alemarram/TFG_EPS_US_26-27/TFG_Estacion_Meteorologica/Node-RED/Dashboard/Flujo_Estacion_meteorologica.png

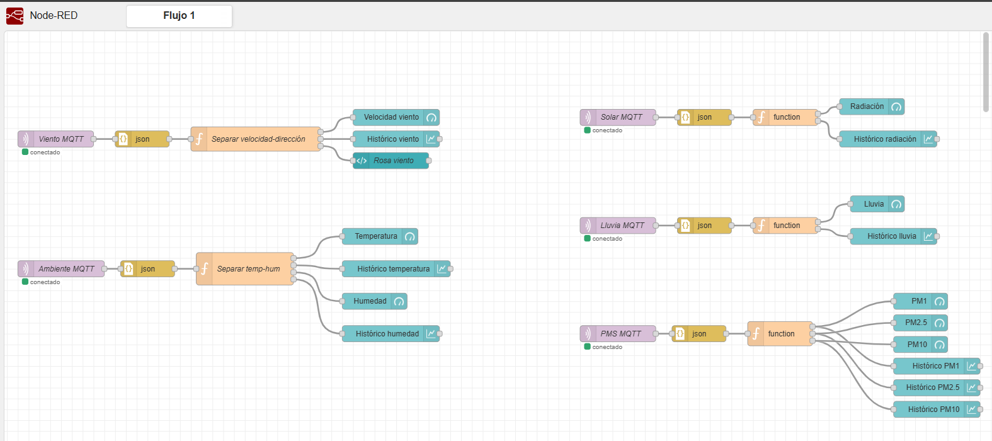
TFG_Estacion_Meteorologica/Node-RED/Dashboard/Flujo_Estacion_meteorologica.png
