alemarram/TFG_EPS_US_26-27/TFG_Estacion_Meteorologica/Node-RED/Dashboard/Radiacion.png

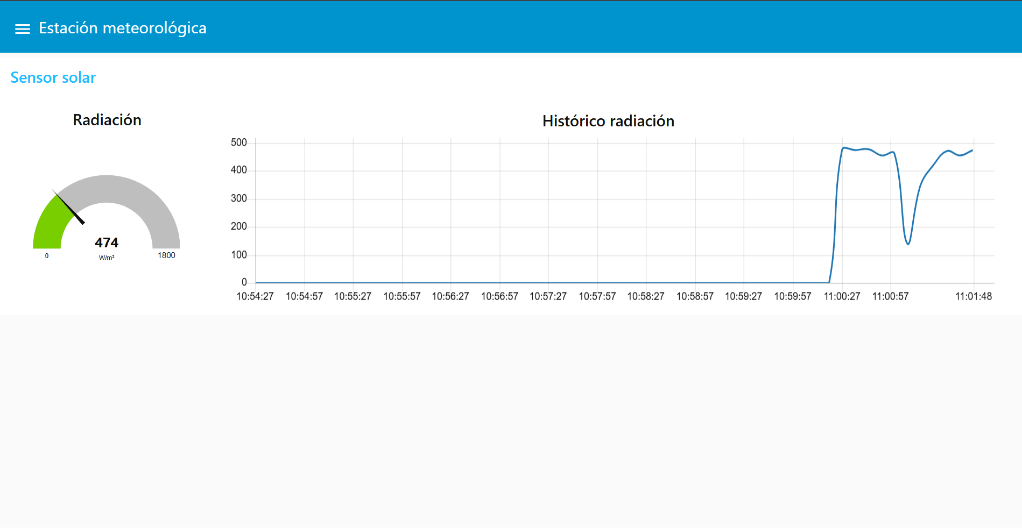
TFG_Estacion_Meteorologica/Node-RED/Dashboard/Radiacion.png
