alemarram/TFG_EPS_US_26-27/TFG_Estacion_Meteorologica/Esquematico/PCB/Plano 2_Componentes_PCB.pdf

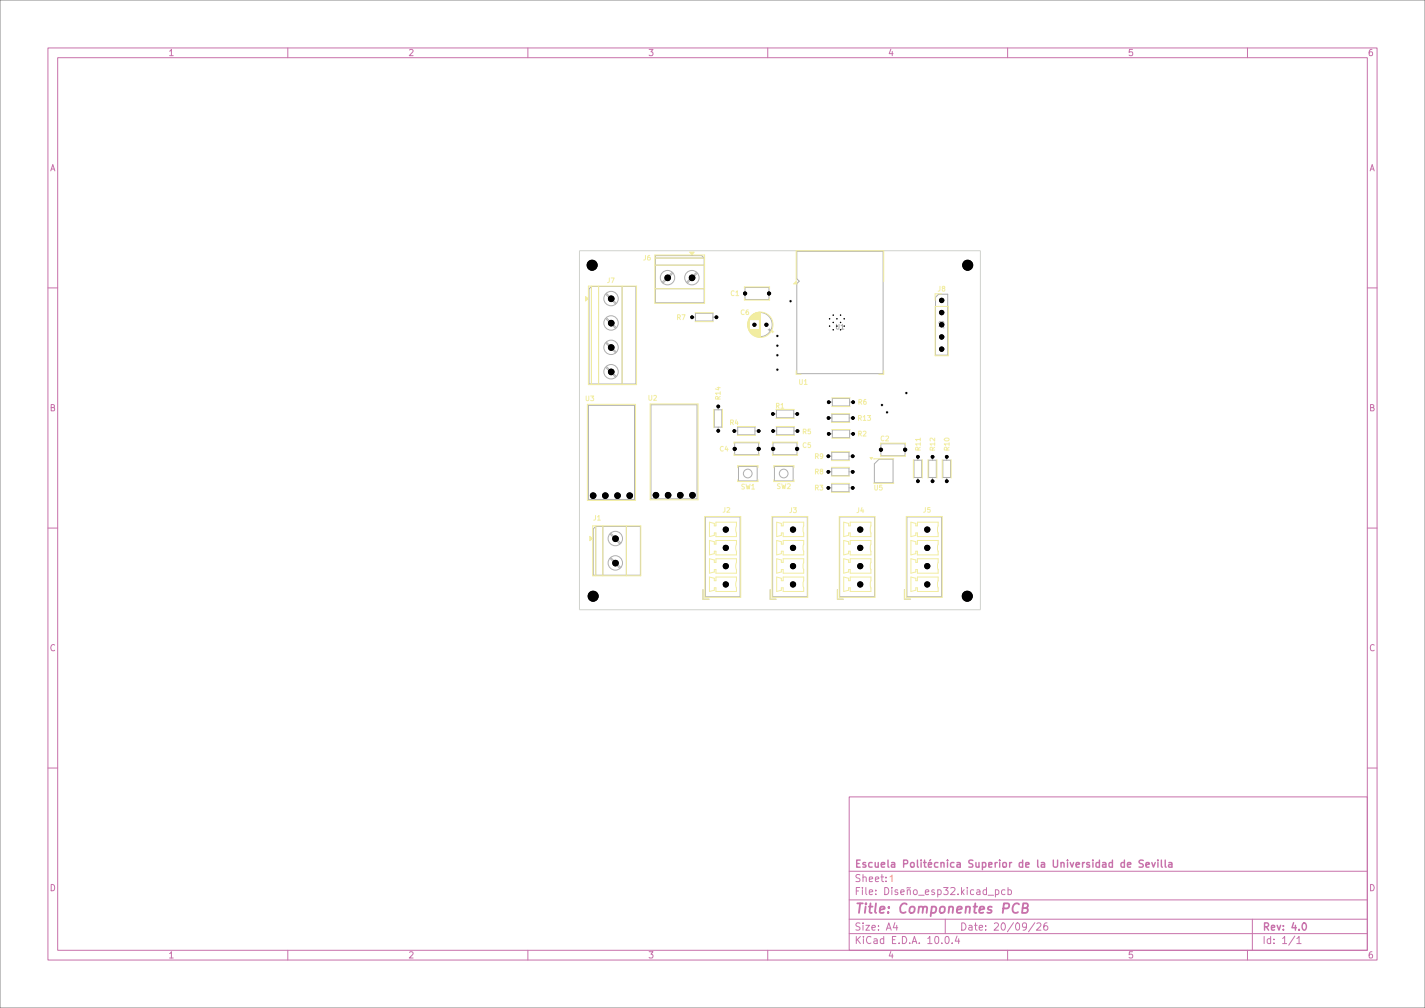
[picture p7: page 1]
