alemarram/TFG_EPS_US_26-27/TFG_Estacion_Meteorologica/Esquematico/PCB/Componentes.pdf

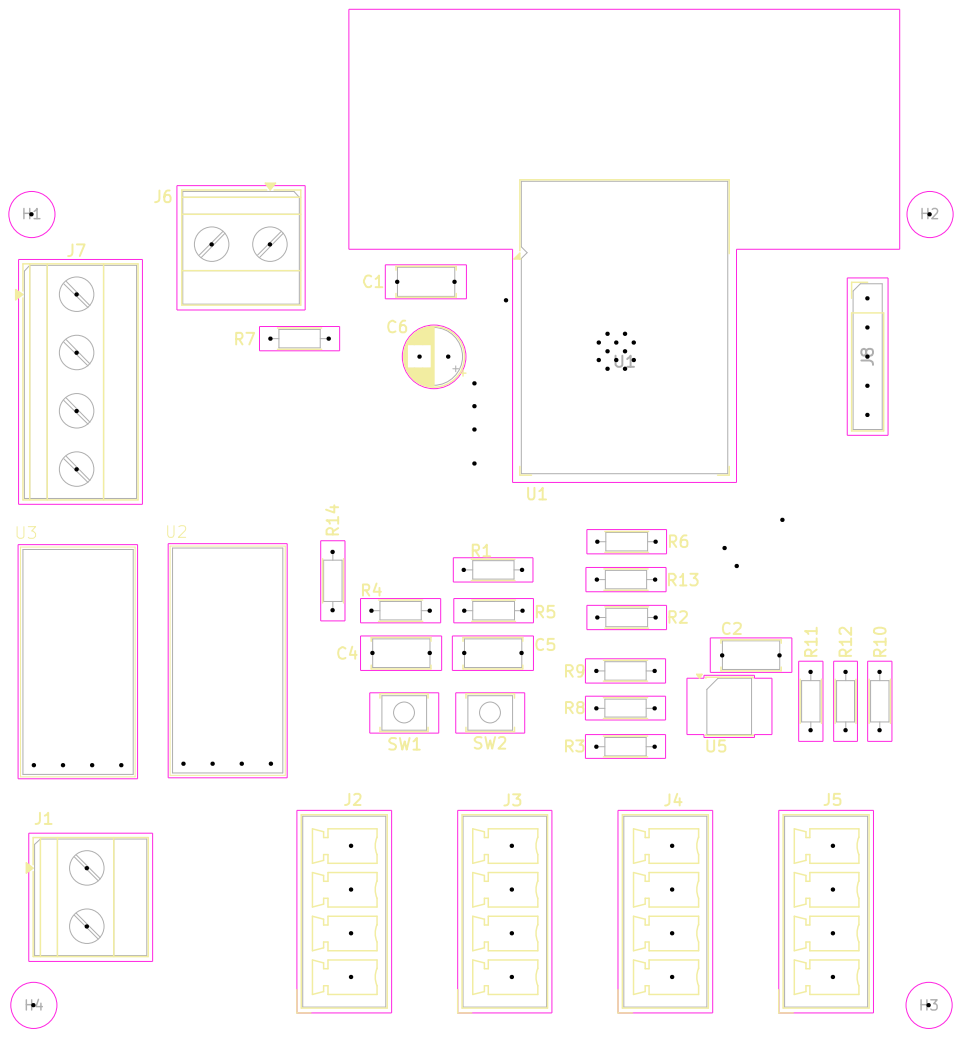
[picture p8: page 1]
