alemarram/TFG_EPS_US_26-27/TFG_Estacion_Meteorologica/Esquematico/Plano 1_Esquemático_PCB.pdf

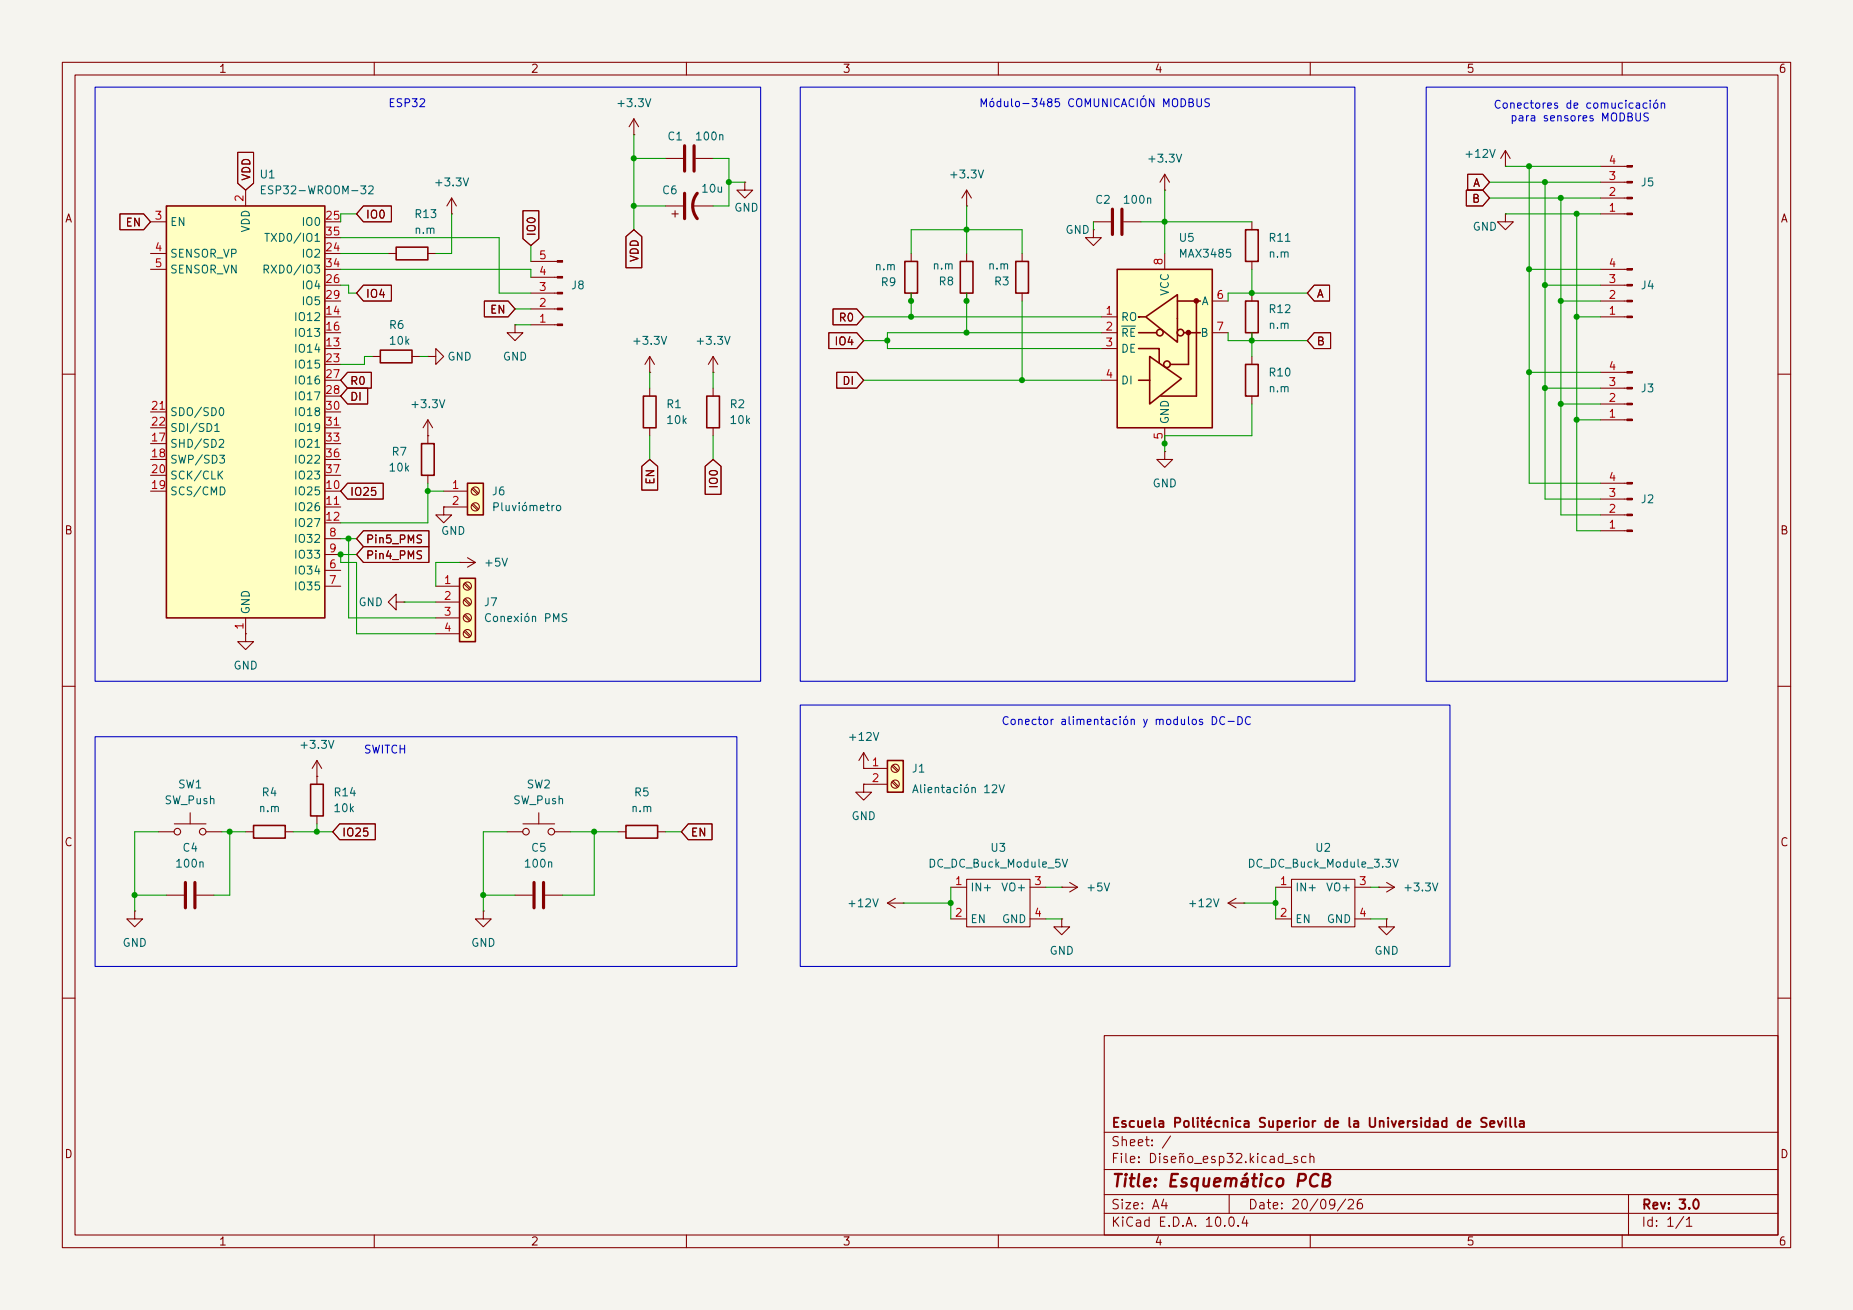
[picture p9: page 1]
