alemarram/TFG_EPS_US_26-27/TFG_Estacion_Meteorologica/Esquematico/Plano 6_Estación_completa.pdf

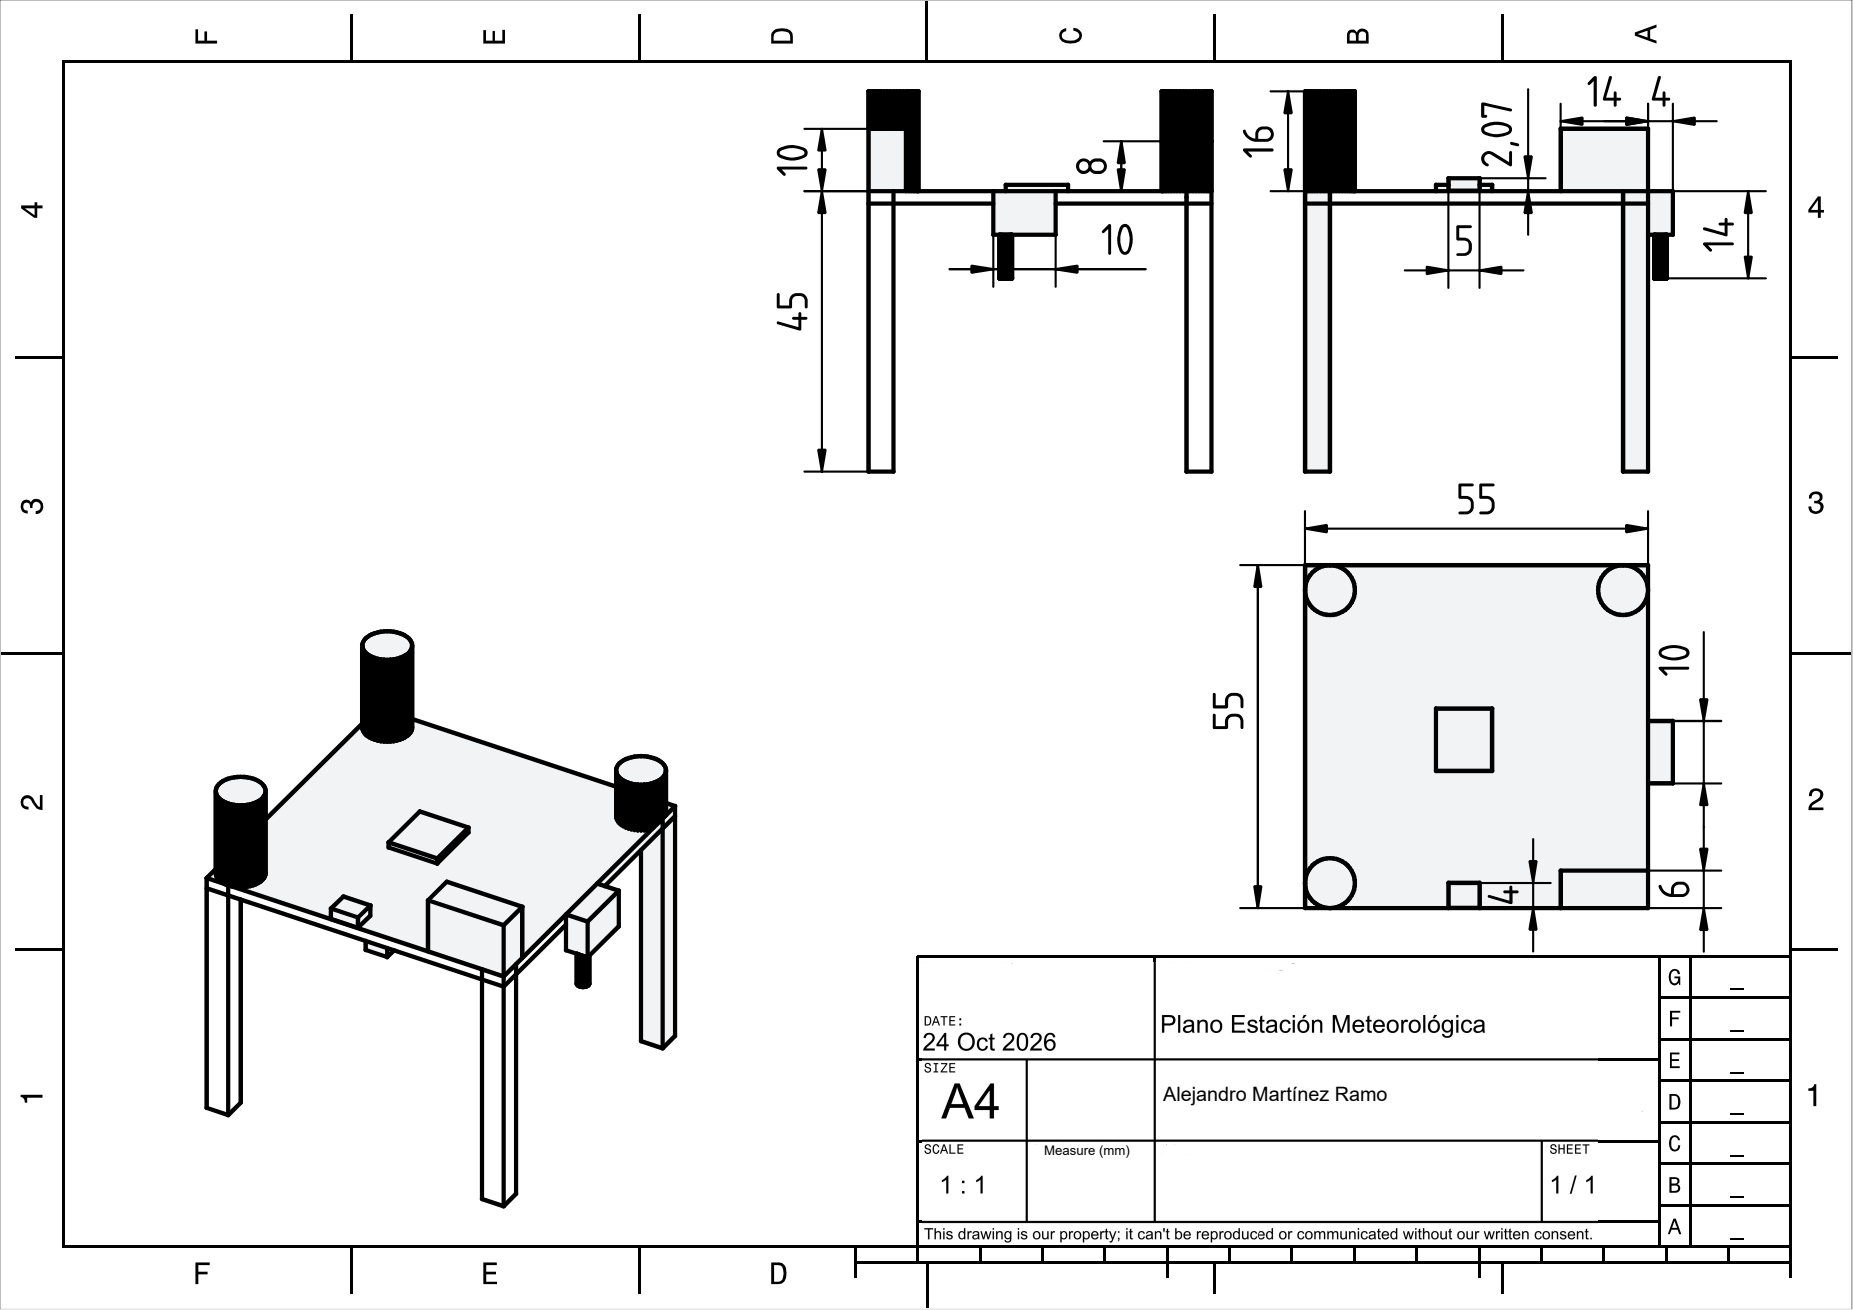
[picture p10: page 1]

DESIGNED BY: DATE: 24 Oct 2026 | Sin no mbre Plano Es tación Meteorológica

SIZE A4 | Alejandro Martínez Ramo

SCALE WEIGHT (kg) Measure (mm) 1:1 | DRAWING NUMB ER SHEET 1/1

This drawing is our property; it can't be reproduce

or communicated without our written consent.
