alemarram/TFG_EPS_US_26-27/TFG_Estacion_Meteorologica/Esquematico/Plano 5_Estación_completa.pdf

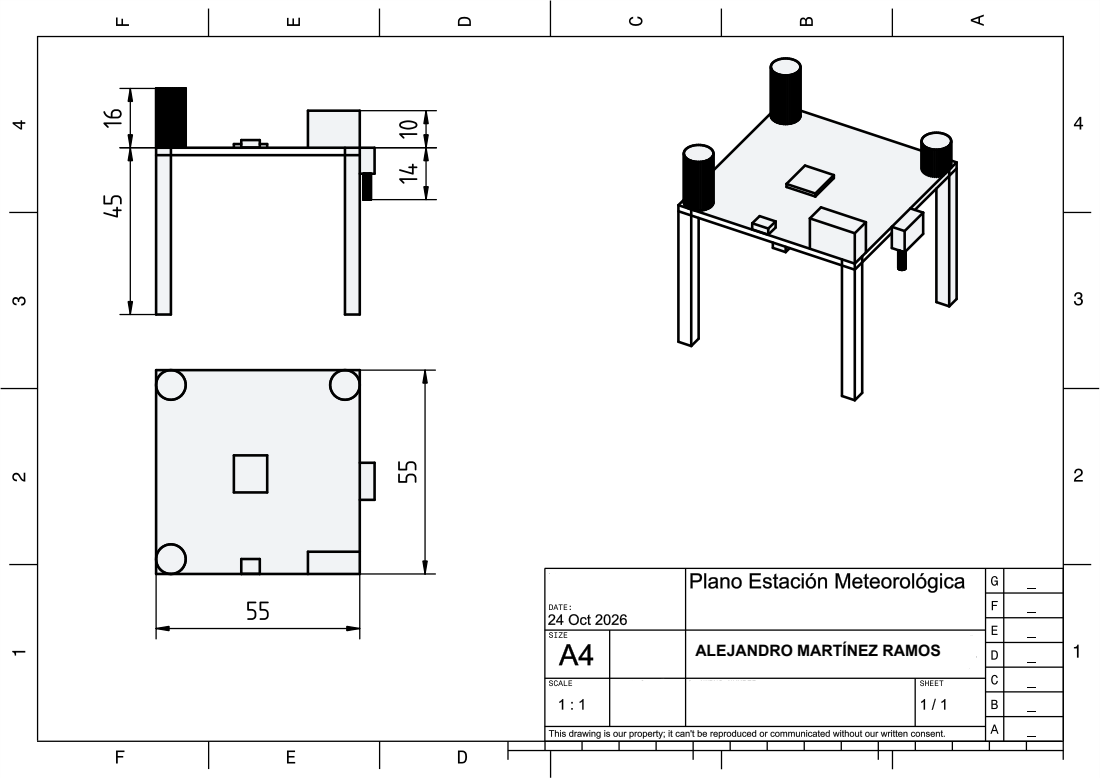
[picture p11: page 1]

ALEJANDRO MARTÍNEZ RAMOS
