alemarram/TFG_EPS_US_26-27/TFG_Estacion_Meteorologica/Esquematico/Esquematico.pdf

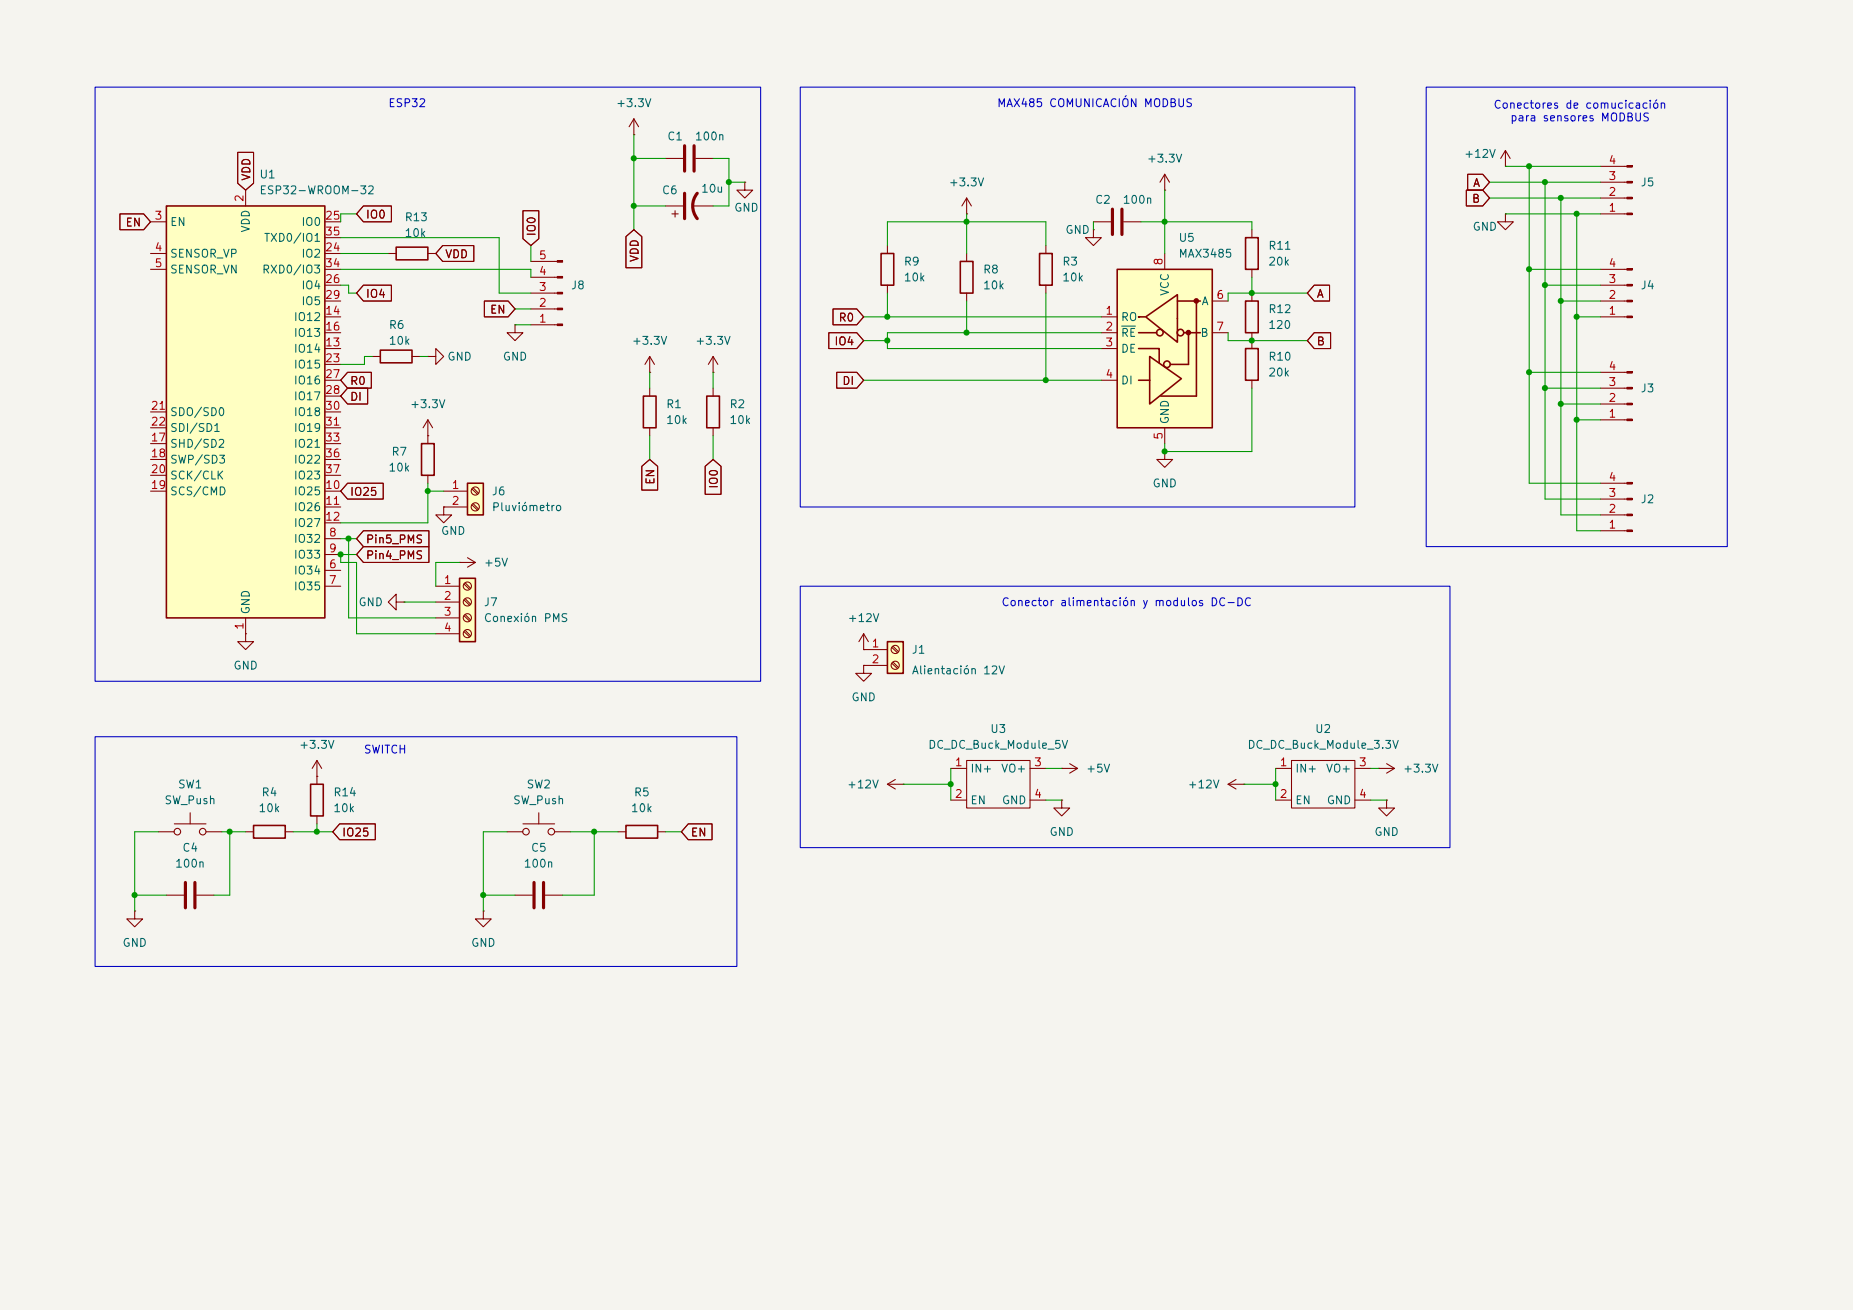
[picture p12: page 1]
