alemarram/TFG_EPS_US_26-27/TFG_Estacion_Meteorologica/Esquematico/PCB/Plano 4_Cara_superior_PCB.pdf

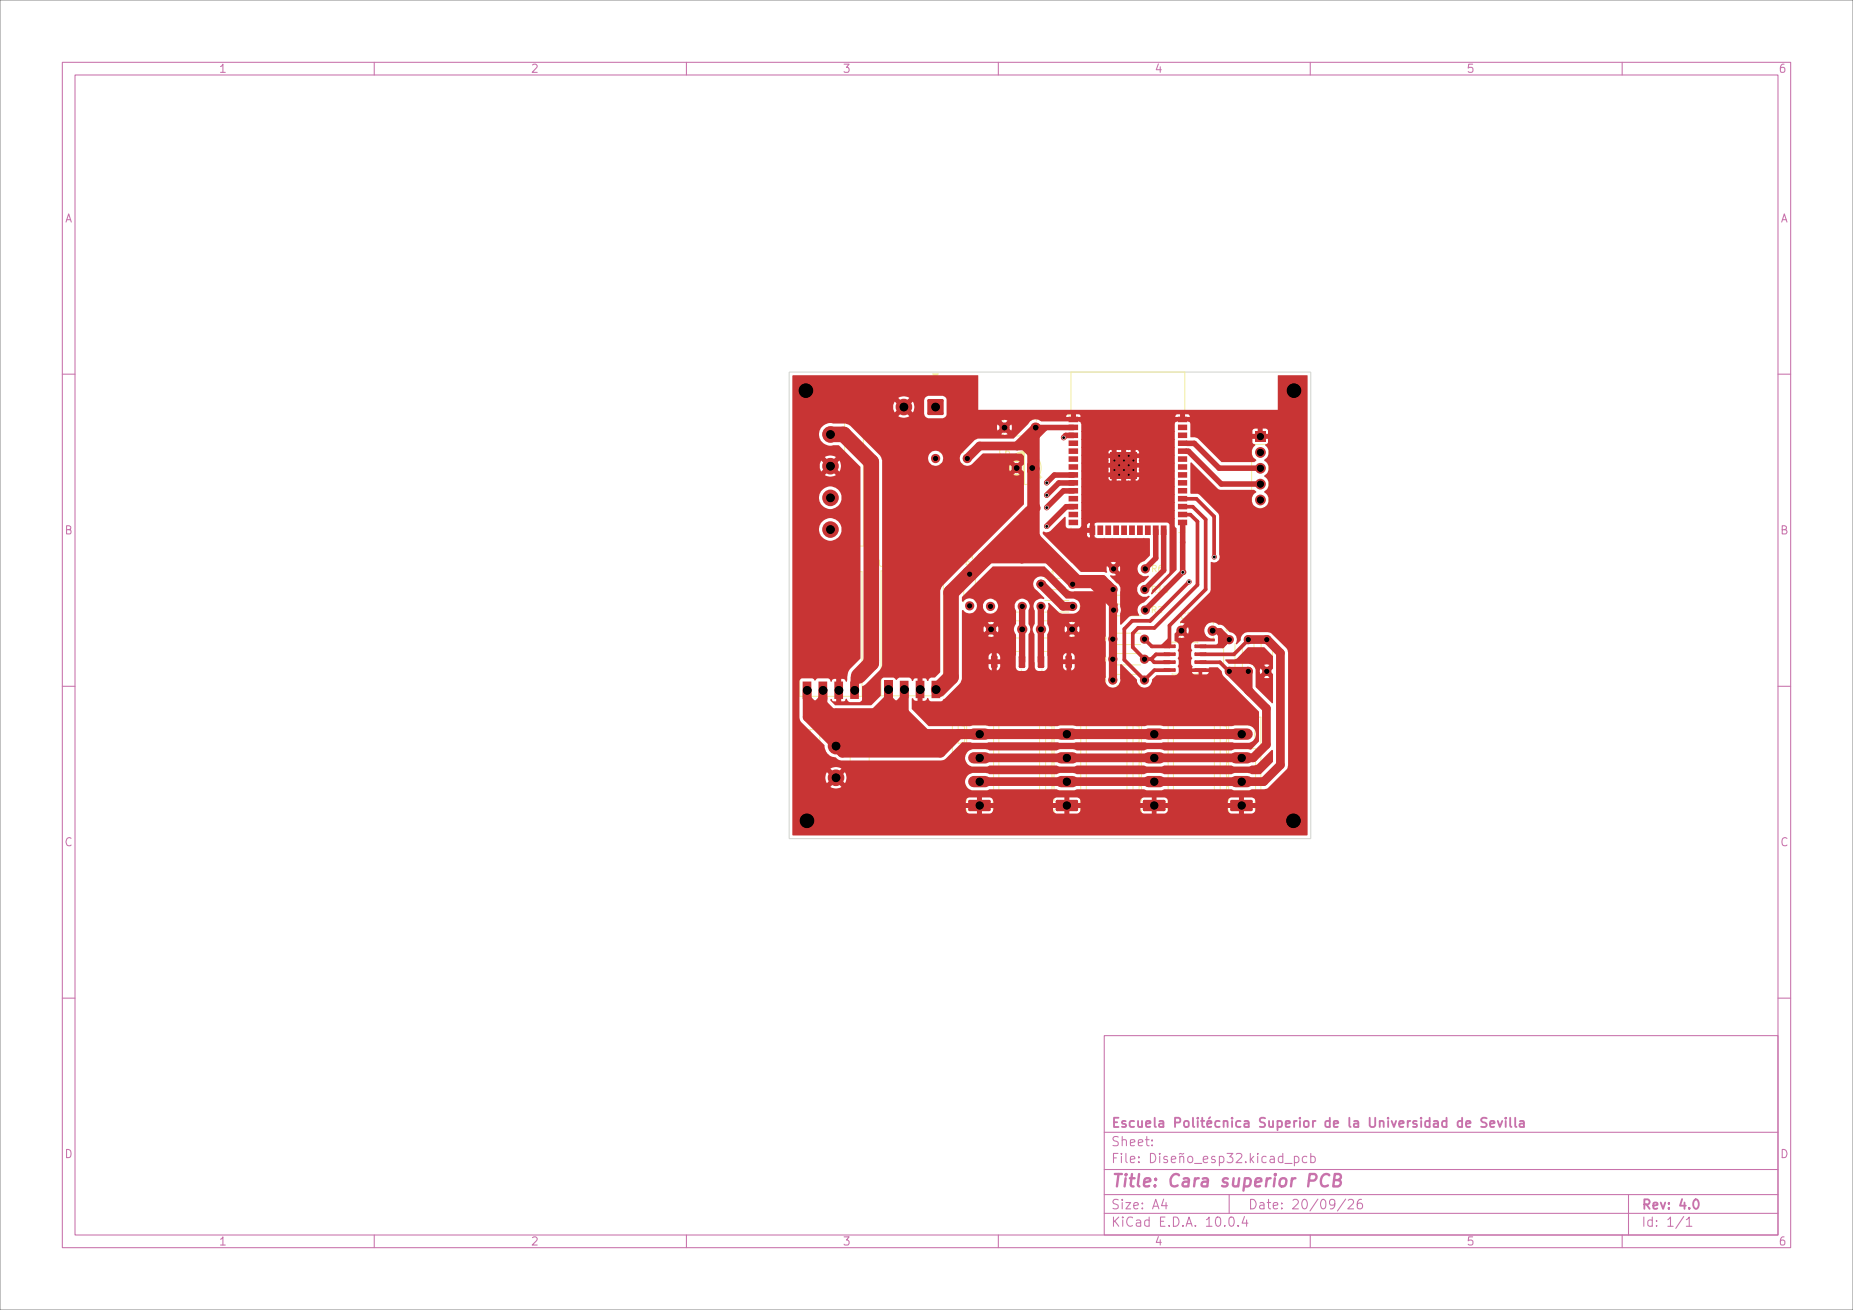
[picture p13: page 1]
