alemarram/TFG_EPS_US_26-27/TFG_Estacion_Meteorologica/Esquematico/PCB/Plano 5_Cotas_PCB.pdf

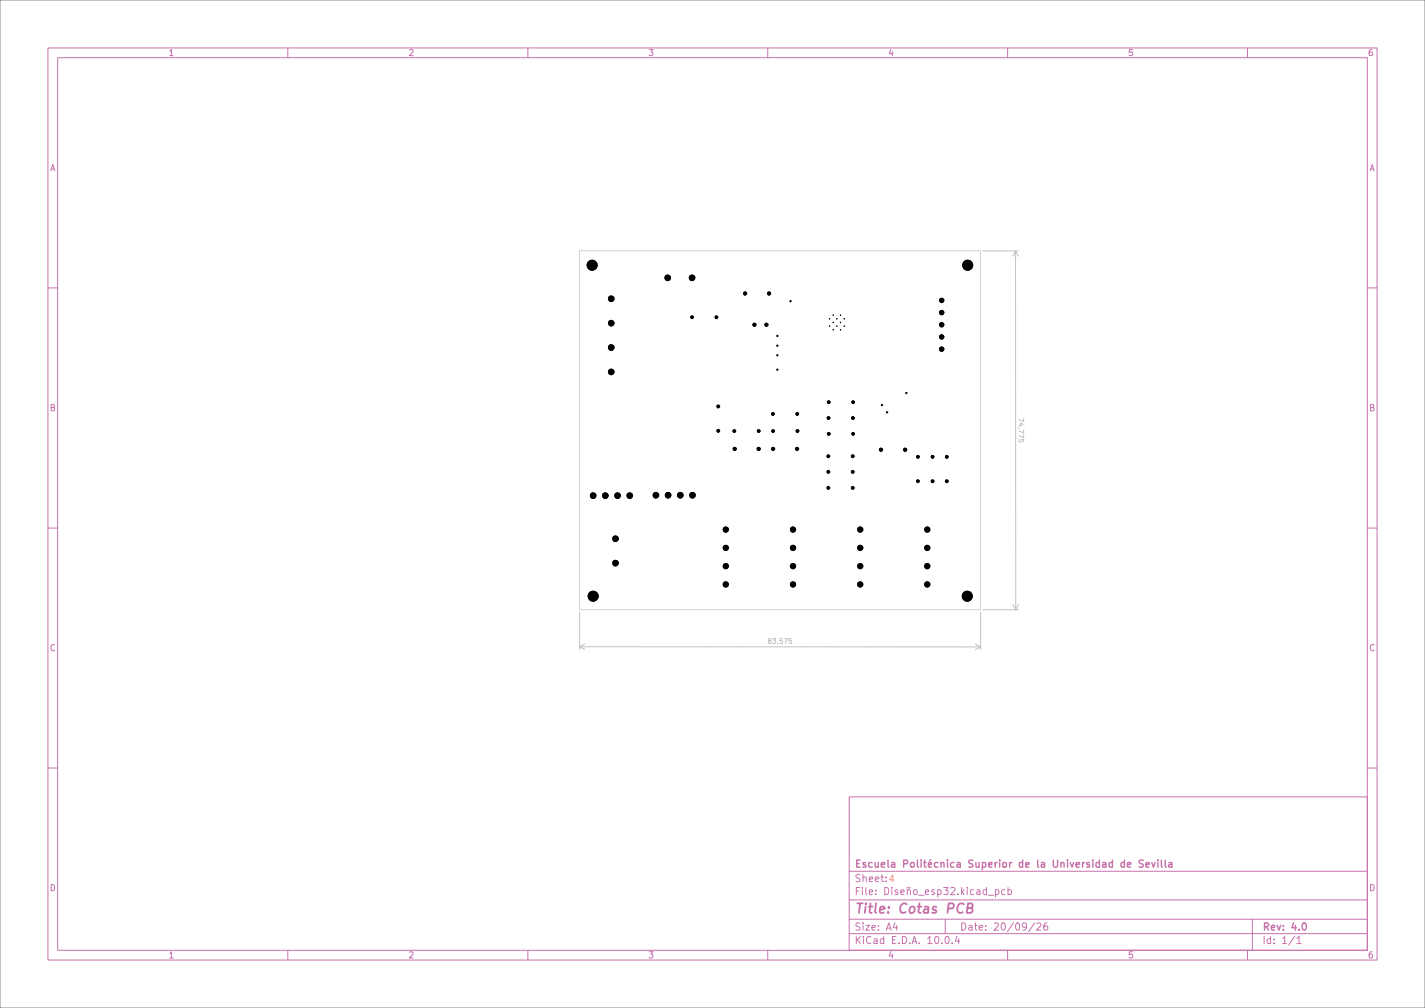
[picture p14: page 1]
