alemarram/TFG_EPS_US_26-27/TFG_Estacion_Meteorologica/Esquematico/PCB/Plano 3_Cara_inferior_PCB.pdf

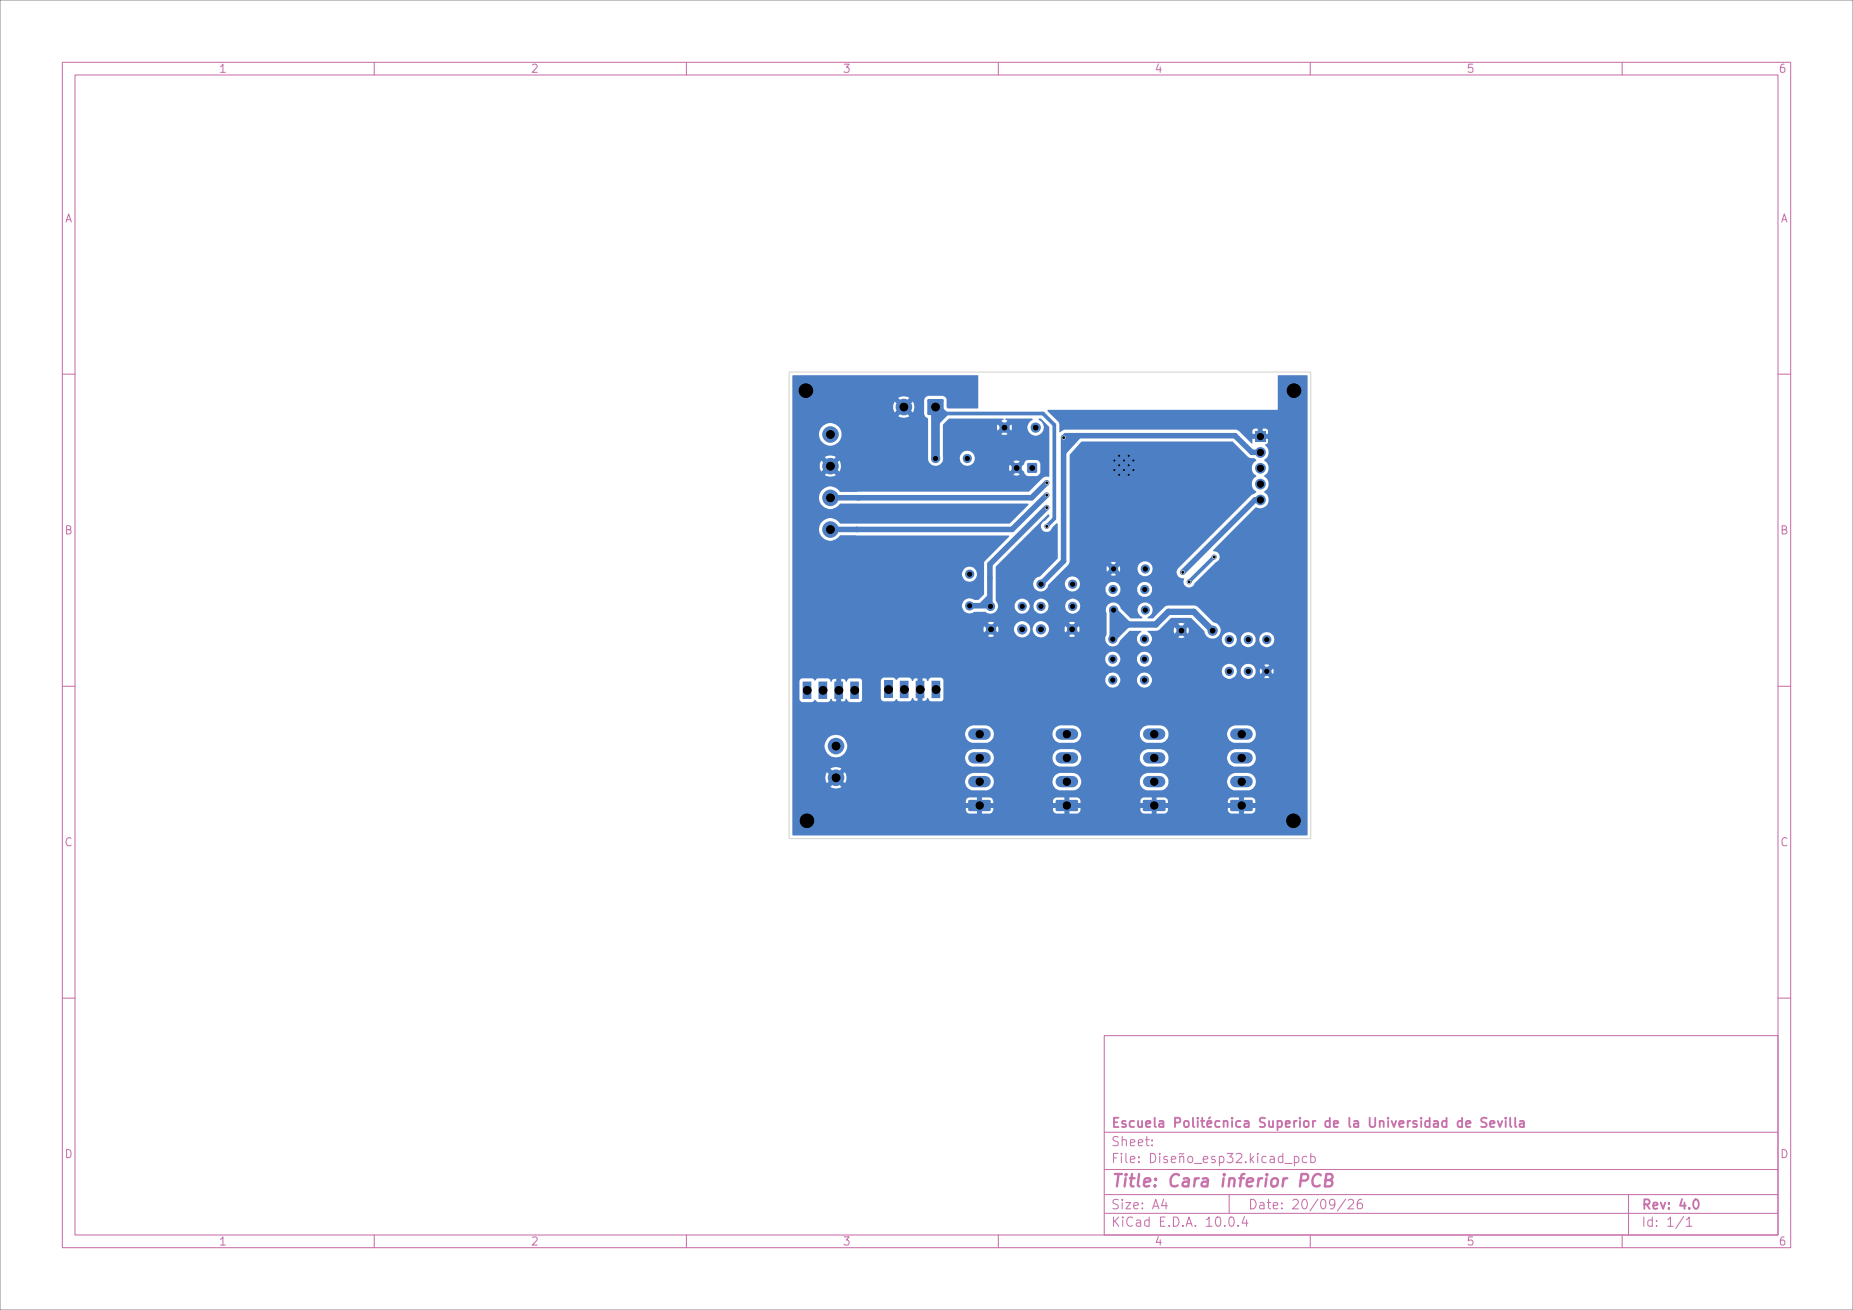
[picture p15: page 1]
