alemarram/TFG_EPS_US_26-27/TFG_Estacion_Meteorologica/Esquematico/PCB/PCB_Cara_Inferior.pdf

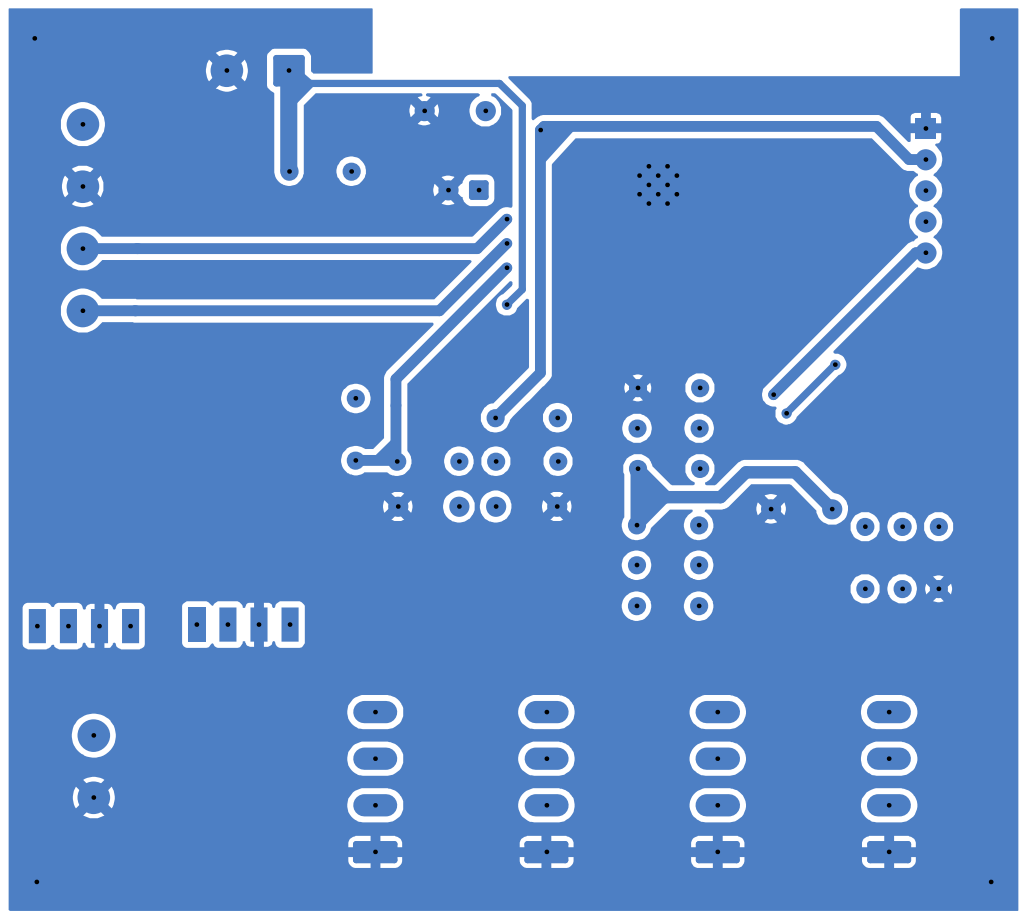
[picture p16: page 1]
