alemarram/TFG_EPS_US_26-27/TFG_Estacion_Meteorologica/Esquematico/PCB/PCB_Cara_Superior.pdf

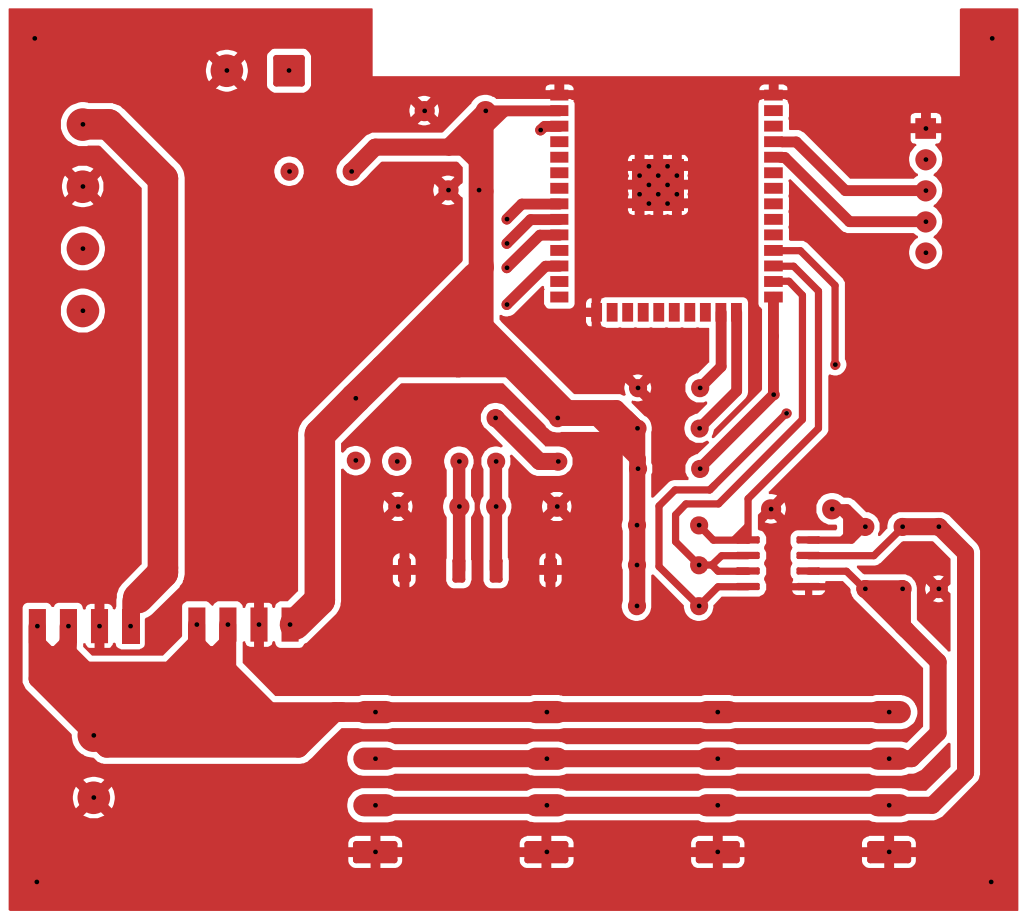
[picture p17: page 1]
